Itaru-Kitano/CoolingBoxWireOrganizer/CoolingBoxWireOrganizer_bom.xlsx

Reference | Value | Datasheet | Qty | 購入ページ | 説明 | 型番 | 金額/個 | 金額 | メモ
C1 | 0.1u | https://www.mouser.jp/datasheet/2/40/KGF-3223650.pdf | 1 | https://www.mouser.jp/ProductDetail/KYOCERA-AVX/KGF15AR71E104KT?qs=Jm2GQyTW%2FbhgeBrrzHnuTw%3D%3D | capacitor | KGF15AR71E104KT | 23 | 23
C2,C3,C4,C5 | 0.01u | https://www.mouser.jp/datasheet/2/281/1/GCM188R71H103KA37_01C-3144181.pdf | 4 | https://www.mouser.jp/ProductDetail/Murata-Electronics/GCM188R71H103KA37J?qs=N3Kl9KD794T3%2FxlXdF0Axg%3D%3D | capacitor | GCM188R71H103KA37J | 26 | 104
D1,D2,D3,D4,D5,D6,D8 | D | https://www.mouser.jp/datasheet/2/80/CDBU0245_HF_RevB-2489203.pdf | 7 | https://www.mouser.jp/ProductDetail/Comchip-Technology/CDBU0245?qs=tw%252BuQ%2FB6PO2XscGM2Q%2FbYQ%3D%3D | diode | CDBU0245 | 55 | 385
J1,J11,J16 | Conn_02x02_Odd_Even | https://www.molex.com/en-us/products/part-detail/5013310407?display=pdf | 3 | https://www.mouser.jp/ProductDetail/Molex/501331-0407?qs=uEWtSLL707WjgxFGXkXwvQ%3D%3D | pico-clasp connector-4pin | 501331-0407 | 102 | 306
J2,J4 | Conn_01x02 | https://www.molex.com/en-us/products/part-detail/430450215?display=pdf | 2 | https://www.mouser.jp/ProductDetail/Molex/43045-0215?qs=R7%2FZKp6KZ2Zl1geLRuWqAQ%3D%3D | micro-fit connector-2pin | 43045-0215 | 363 | 726
J3 | Conn_01x08 | https://www.molex.com/en-us/products/part-detail/5013310807?display=pdf | 1 | https://www.mouser.jp/ProductDetail/Molex/501331-0807?qs=uEWtSLL707WCWoLr2aeFsQ%3D%3D | pico-clasp connector-8pin | 501331-0807 | 124 | 124
J5 | Conn_01x10_Pin | https://app.adam-tech.com/products/download/data_sheet/201605/ph1-xx-ua-data-sheet.pdf | 1 | https://www.digikey.jp/ja/products/detail/adam-tech/PH1-10-UA/9830653?productid=9830653&gad_source=1 | pin header_1x10_p2.54_vertical | PH1-10-UA | 29 | 29
J6,J7,J8,J10,J13 | Conn_01x08_Pin | https://app.adam-tech.com/products/download/data_sheet/201605/ph1-xx-ua-data-sheet.pdf | 5 | https://www.digikey.jp/ja/products/detail/adam-tech/PH1-08-UA/9830442?productid=9830442&gad_source=1 | pin header_1x08_p2.54_vertical | PH1-08-UA | 24 | 120
J9,J12 | Conn_02x03_Odd_Even | https://www.molex.com/en-us/products/part-detail/430450615?display=pdf | 2 | https://www.mouser.jp/ProductDetail/Molex/43045-0615?qs=ODlIKnK5hgef9VmmmFfM0A%3D%3D | micro-fit connector-6pin | 43045-0615 | 540 | 1080
J15 | Conn_02x18_Odd_Even | https://app.adam-tech.com/products/download/data_sheet/202065/ph2-xx-ua-data-sheet.pdf | 1 | https://www.digikey.jp/ja/products/detail/adam-tech/PH2-18-UA/9830421 | pin header_2x18_p2.54_vertical | PH2-18-UA | 49 | 49
J18,J19,J23 | DILB16P-223TLF | https://www.mouser.jp/datasheet/2/18/1/10052485-2577567.pdf | 3 | https://www.mouser.jp/ProductDetail/Amphenol-FCI/DILB16P-223TLF?qs=dNsYR%2FH0PyMYRp3sTWpoVA%3D%3D&gad_source=1 | dip socket for relay | DILB16P-223TLF | 71 | 213
L1,L2,L3,L4,L5,L6,L7,L8 | L_Ferrite | https://www.mouser.jp/datasheet/2/281/ENFA0003-1915778.pdf | 8 | https://www.mouser.jp/ProductDetail/Murata-Electronics/BLM18KG331SN1D?qs=rvfpa0%252BU10NzC2vi4JWfgQ%3D%3D | ferrite bead | BLM18KG331SN1D | 17 | 136
R1,R12,R13,R15,R17,R19 | 10000 | https://www.vishay.com/docs/20035/dcrcwe3.pdf | 6 | https://www.mouser.jp/ProductDetail/Vishay-Dale/CRCW060310K0FKEI | resistor 10k ohm | CRCW060310K0FKEI | 17 | 102
R2 | 3900 | https://www.vishay.com/docs/28758/tnpw_e3.pdf | 1 | https://www.mouser.jp/ProductDetail/Vishay-Dale/TNPW06033K90BEEA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 | resistor 3.9k ohm | TNPW06033K90BEEA | 63 | 63
R3 | 1800 | https://www.mouser.jp/datasheet/2/315/AOA0000C307-1149632.pdf | 1 | https://www.mouser.jp/ProductDetail/Panasonic/ERA-3ARB182V | resistor 1.8k ohm | ERA-3ARB182V | 91 | 91
R4,R5,R6,R7,R8,R9,R10,R11 | 390 | https://www.vishay.com/docs/28952/mcs0402at-mct0603at-mcu0805at-mca1206at.pdf | 8 | https://www.mouser.jp/ProductDetail/Vishay/MCT0603MD3900BP500 | resistor 390k ohm | MCT0603MD3900BP500 | 71 | 568
R14,R16,R18,R20 | 1000 | https://www.vishay.com/docs/28705/mcx0x0xpro.pdf | 4 | https://www.mouser.jp/ProductDetail/Vishay-Beyschlag/MCT06030C1001FP500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 | resistor 1k ohm | MCT06030C1001FP500 | 17 | 68
U1,U2,U3,U4 | MAX31855KASA | http://datasheets.maximintegrated.com/en/ds/MAX31855.pdf | 4 | https://www.mouser.jp/ProductDetail/Analog-Devices-Maxim-Integrated/MAX31855KASA+T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 | max31855 | MAX31855KASA+T | 1450 | 5800
J14,J17,J21,J22 | Conn_01x02 | https://www.molex.com/en-us/products/part-detail/5013310207?display=pdf | 4 | https://www.mouser.jp/ProductDetail/Molex/501331-0207?qs=uEWtSLL707XUoNps1caEaA%3D%3D | pico-clasp connector-2pin | 501331-0207 | 92 | 368
J20 | Conn_02x03_Odd_Even | https://app.adam-tech.com/products/download/data_sheet/202065/ph2-xx-ua-data-sheet.pdf | 1 | https://www.digikey.jp/ja/products/detail/adam-tech/PH2-06-UA/9830396?productid=9830396&gad_source=1 | pin header_2x03_p2.54_vertical | PH2-06-UA | 18 | 18
 |  |  |  |  |  |  |  | 0
 |  |  |  |  |  |  |  | 0
 |  | https://www.molex.com/content/dam/molex/molex-dot-com/products/automated/en-us/salesdrawingpdf/501/501330/5013300400_sd.pdf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 | 3 | https://www.mouser.jp/ProductDetail/Molex/501330-0400?qs=aXGKoampmnm6Ru8v6Lp%2Frg%3D%3D | pico-clasp housing-4pin | 501330-0400 | 38 | 114
 |  | https://www.molex.com/en-us/products/part-detail/430250200?display=pdf | 2 | https://www.mouser.jp/ProductDetail/Molex/43025-0200?qs=4XSMV6Twtb2B3B7qTwcqgQ%3D%3D | micro-fit housing-2pin | 43025-0200 | 55 | 110
 |  | https://www.molex.com/en-us/products/part-detail/5013300800?display=pdf | 1 | https://www.mouser.jp/ProductDetail/Molex/501330-0800?qs=aXGKoampmnmr%252BxiReHihlw%3D%3D | pico-clasp housing-8pin | 501330-0800 | 35 | 35
 |  | https://www.molex.com/en-us/products/part-detail/430250600?display=pdf | 2 | https://www.mouser.jp/ProductDetail/Molex/43025-0600?qs=mrPiglD9aYJrq7XWj%2FGMFg%3D%3D | micro-fit housing-6pin | 43025-0600 | 86 | 172
 |  | https://www.molex.com/en-us/products/part-detail/5013300200?display=pdf | 4 | https://www.mouser.jp/ProductDetail/Molex/501330-0200?qs=uEWtSLL707VDdEXASWutQw%3D%3D | pico-clasp housing-2pin | 501330-0200 | 53 | 212
 |  | https://www.molex.com/en-us/products/part-detail/5011937000?display=pdf | 28 | https://www.mouser.jp/ProductDetail/Molex/501193-7000?qs=d0WKAl%252BL4KbeebyzLG7lVA%3D%3D | pico-clasp crimp | 501193-7000 | 28 | 784
 |  | https://www.molex.com/content/dam/molex/molex-dot-com/products/automated/en-us/salesdrawingpdf/430/43030/430300001_sd.pdf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 | 16 | https://www.mouser.jp/ProductDetail/Molex/43030-0002-Cut-Strip | micro-fit crimp | 43030-0002 | 17 | 272
 |  |  |  |  |  |  |  | 0
 |  | https://omronfs.omron.com/en_US/ecb/products/pdf/en-g3vm_41ar_dr.pdf | 12 | https://www.digikey.jp/ja/products/detail/omron-electronics-inc-emc-div/G3VM-41AR/3175479 | control relay | G3VM-41AR | 1323 | 15876
 |  | https://www.mouser.jp/datasheet/2/307/OMRNS02519_1-2559982.pdf | 2 | https://www.mouser.jp/ProductDetail/Omron-Automation-and-Safety/G2R-1-SN-DC12S?qs=CQJ0XtrV64ulWIzWmO6GHQ%3D%3D | peltier power relay | G2R-1-SN-DC12 | 2353 | 4706
 |  |  | 3 | https://www.monotaro.com/p/5059/4050/?t.q=p2rfz-05-e | peltier power relay DIN rail socket | P2RFZ-05-E | 479 | 1437
 |  | https://mm.digikey.com/Volume0/opasdata/d220001/medias/docus/2878/HE%20Relays%20TV-10%2C15.pdf | 1 | https://www.digikey.jp/ja/products/detail/panasonic-electric-works/HE1AN-S-DC12V/570790 | AC100V inter lock power relay | HE1AN-S-DC12V | 2581 | 2581
 |  | https://industry.panasonic.com/global/en/downloads/?file_cd=401131&tab=catalog&series_cd=2463 | 1 | https://www.digikey.jp/ja/products/detail/panasonic-electric-works/JH1-SF/635214 | AC100V inter lock power relay DIN rail socket | JH1-SF | 1838 | 1838
 |  |  |  |  |  |  |  | 0
 |  |  |  |  |  |  |  | 0
 |  |  |  |  |  |  |  | 0
 |  |  | 1 | https://www.amazon.co.jp/%E3%82%A8%E3%83%B3%E3%82%B8%E3%83%8B%E3%82%A2-%E7%B2%BE%E5%AF%86%E5%9C%A7%E7%9D%80%E3%83%9A%E3%83%B3%E3%83%81-%E3%83%80%E3%82%A4%E3%8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 | crimping tool | PAD-11 | 7445 | 7445
 |  | https://www.mouser.jp/datasheet/2/260/MWEC_S_A0013016761_1-2552161.pdf | 1 | https://www.mouser.jp/ProductDetail/MEAN-WELL/MDR-60-12 | power supply 12V | MDR-60-12 | 3841 | 3841
 |  |  |  |  |  |  |  | 0
 |  |  |  |  |  |  |  | 0
 |  |  |  |  |  |  |  | 0
 |  | https://www.phoenixcontact.com/en-us/products/distributor-terminal-block-ptfix-66x25-ns35a-gy-3273198?type=pdf | 3 | https://www.digikey.jp/ja/products/detail/phoenix-contact/3273198/7596982 | terminal block | 3273198 | 656 | 1968 | 九州大学
 |  | https://mm.digikey.com/Volume0/opasdata/d220001/medias/docus/388/3210499.pdf | 2 | https://www.digikey.jp/ja/products/detail/phoenix-contact/3210499/2263754 | power cord splicing | 3210499 | 1219 | 2438 | 九州大学
 |  |  |  |  |  |  |  |  | 九州大学
 |  |  |  |  |  |  |  | 0 | 九州大学
 |  |  | 2 | https://www.yukilabo.co.jp/index.php?LECOFRAME | Circuit Base Pillar | F25L-415.0-2-U | 740/m | 1994 | 九州大学
 |  |  | 4 |  | 鉄後入れTロック25 | TL2X | 110 | 440 | 九州大学
 |  |  | 4 |  | テーパーボルト25 | TB25 | 30 | 120 | 九州大学
 |  |  | 12 |  | Fナット25 | NF25-M4 | 32 | 384 | 九州大学
 |  |  |  |  |  |  |  | 0 | 九州大学
 |  |  | 1 | https://www.monotaro.com/p/0964/9981/?t.q=9649981 | アルミ(A5052)切板 厚さ3mm(Front Panel) |  | 3290 | 3290 | 九州大学
 |  |  | 2 | https://www.monotaro.com/p/3710/8881/?t.q=37108881 | 配線ダクト |  | 1898 | 3796 | 九州大学
 |  |  | 2 | https://www.monotaro.com/p/6729/8762/?t.q=67298762 | DINレール |  | 399 | 798 | 九州大学
 |  |  |  |  |  |  | 合計金額 | 65024
