Itaru-Kitano/CoolingBoxWireOrganizer/(commit log)

2024-06-17 change Vin of MAX31855 5V to 3.3V
    [CoolingBoxWireOrganizer.kicad_pcb, CoolingBoxWireOrganizer.kicad_sch]
2024-06-19 fix the edge of 5V and 3.3V
    [CoolingBoxWireOrganizer.kicad_pcb]
2024-06-19 add power connector in sch
    [CoolingBoxWireOrganizer.kicad_pcb, CoolingBoxWireOrganizer.kicad_sch]
2024-06-19 add two 2x2 digital connector and analog spare connector. Then, some wire connected.
    [CoolingBoxWireOrganizer.kicad_pcb, CoolingBoxWireOrganizer.kicad_sch]
2024-06-20 connected all wires, added text, and conducted DRC
    [CoolingBoxWireOrganizer.kicad_pcb, CoolingBoxWireOrganizer.kicad_sch]
2024-06-20 fix some details
    [CoolingBoxWireOrganizer-B_Cu.gbr, CoolingBoxWireOrganizer-B_Mask.gbr, CoolingBoxWireOrganizer-B_Paste.gbr, CoolingBoxWireOrganizer-B_Silkscreen.gbr, CoolingBoxWireOrganizer-Edge_Cuts.gbr, CoolingBoxWireOrganizer-F_Cu.gbr, CoolingBoxWireOrganizer-F_Mask.gbr, CoolingBoxWireOrganizer-F_Paste.gbr]
2024-06-28 take enoough space to nut be turned. chage the configuration of spare connector
    [CoolingBoxWireOrganizer.kicad_pcb, CoolingBoxWireOrganizer.kicad_sch]
2024-07-02 complete version 1.1
    [CoolingBoxWireOrganizer.kicad_pcb]
2024-07-02 add circuit around chiller alarm and chiller read signal
    [CoolingBoxWireOrganizer.kicad_pcb, CoolingBoxWireOrganizer.kicad_sch]
2024-07-04 add circuit around chiller alarm
    [CoolingBoxWireOrganizer.kicad_pcb, CoolingBoxWireOrganizer.kicad_sch]
2024-07-09 change one digital spare to reset.
    [CoolingBoxWireOrganizer.kicad_pcb, CoolingBoxWireOrganizer.kicad_sch]
2024-07-11 add SSR circuit
    [CoolingBoxWireOrganizer.kicad_pcb, CoolingBoxWireOrganizer.kicad_sch]
2024-07-12 fix details.
    [CoolingBoxWireOrganizer.kicad_pcb]
2024-08-27 add MAX31855
    [CoolingBoxWireOrganizer.kicad_pcb, CoolingBoxWireOrganizer.kicad_sch]
2024-08-27 add relay(G3VM-41AR) except AC100V_intlk(chiller)'s relay. And delete MAX31855's molex connector that is remains of version1.2
    [CoolingBoxWireOrganizer.kicad_pcb, CoolingBoxWireOrganizer.kicad_sch]
2024-08-27 set the connector to each devices at the latter part of the relay(G3VM-41AR).
    [CoolingBoxWireOrganizer.kicad_pcb, CoolingBoxWireOrganizer.kicad_sch]
2024-08-29 before change branch
    [CoolingBoxWireOrganizer.kicad_pcb, CoolingBoxWireOrganizer.kicad_sch]
2024-08-30 add capacitor to MAX31855, and connect the thermocouple terminal to MAX31855.
    [CoolingBoxWireOrganizer.kicad_pcb, CoolingBoxWireOrganizer.kicad_sch]
2024-08-30 before changing branch
    [CoolingBoxWireOrganizer.kicad_pcb, CoolingBoxWireOrganizer.kicad_sch]
2024-09-05 update circuit around MAX31855 (imitate MAX board module).
    [CoolingBoxWireOrganizer.kicad_pcb, CoolingBoxWireOrganizer.kicad_sch]
2024-09-07 started to design wiring but there isn't enough space. So, I will try to change molex connector mini-fit to micro-fit which is SMD in another branch(version2.1).
    [CoolingBoxWireOrganizer.kicad_pcb, CoolingBoxWireOrganizer.kicad_sch]
2024-09-11 added almost all parts and decided the location of them and designed some wires. I need to add emergency cuicuit and chiller alarm circuit futher more later.
    [CoolingBoxWireOrganizer.kicad_pcb, CoolingBoxWireOrganizer.kicad_sch]
2024-09-16 add diodes for back electromotive force absorption to chiller alarm circuit
    [CoolingBoxWireOrganizer.kicad_pcb, CoolingBoxWireOrganizer.kicad_sch]
2024-09-17 fix details
    [CoolingBoxWireOrganizer.kicad_pcb, CoolingBoxWireOrganizer_bom.csv, CoolingBoxWireOrganizer_bom.xlsx]
2024-10-03 fix the wires around MAX31855
    [CoolingBoxWireOrganizer.kicad_pcb, CoolingBoxWireOrganizer.kicad_sch, CoolingBoxWireOrganizer_bom.xlsx]
2024-10-03 edited bom
    [CoolingBoxWireOrganizer_bom.xlsx]
2024-10-04 add peltier power relay socket to bom
    [CoolingBoxWireOrganizer_bom.xlsx]
2024-10-06 fix the bom
    [CoolingBoxWireOrganizer_bom.xlsx]
2024-10-07 add gerber file
    [CoolingBoxWireOrganizer-B_Cu.gbr, CoolingBoxWireOrganizer-B_Mask.gbr, CoolingBoxWireOrganizer-B_Paste.gbr, CoolingBoxWireOrganizer-B_Silkscreen.gbr, CoolingBoxWireOrganizer-Edge_Cuts.gbr, CoolingBoxWireOrganizer-F_Cu.gbr, CoolingBoxWireOrganizer-F_Mask.gbr, CoolingBoxWireOrganizer-F_Paste.gbr]
2024-10-07 add information of terminal block and what is used at Kyushu site
    [CoolingBoxWireOrganizer.kicad_pcb, CoolingBoxWireOrganizer_bom.xlsx]
2024-10-08 change the Vin to GND about Arduino control
    [CoolingBoxWireOrganizer.kicad_pcb, CoolingBoxWireOrganizer.kicad_sch]
2024-10-08 update gerber file
    [CoolingBoxWireOrganizer-B_Cu.gbr, CoolingBoxWireOrganizer-B_Mask.gbr, CoolingBoxWireOrganizer-B_Paste.gbr, CoolingBoxWireOrganizer-B_Silkscreen.gbr, CoolingBoxWireOrganizer-Edge_Cuts.gbr, CoolingBoxWireOrganizer-F_Cu.gbr, CoolingBoxWireOrganizer-F_Mask.gbr, CoolingBoxWireOrganizer-F_Paste.gbr]
2024-10-08 change the silk 'Arduino control' to 'Arduino reset'
    [CoolingBoxWireOrganizer-B_Cu.gbr, CoolingBoxWireOrganizer-B_Mask.gbr, CoolingBoxWireOrganizer-B_Paste.gbr, CoolingBoxWireOrganizer-B_Silkscreen.gbr, CoolingBoxWireOrganizer-Edge_Cuts.gbr, CoolingBoxWireOrganizer-F_Cu.gbr, CoolingBoxWireOrganizer-F_Mask.gbr, CoolingBoxWireOrganizer-F_Paste.gbr]
2024-10-08 update the gerber file
2024-10-23 change the format of bom(add memo)
    [CoolingBoxWireOrganizer_bom.xlsx]
2024-10-23 organaize version2.1 folder
    [CoolingBoxWireOrganizer_bom.csv]
2024-10-23 2 organaize version2.1 folder
    [CoolingBoxWireOrganizer-B_Cu.gbr, CoolingBoxWireOrganizer-B_Mask.gbr, CoolingBoxWireOrganizer-B_Paste.gbr, CoolingBoxWireOrganizer-B_Silkscreen.gbr, CoolingBoxWireOrganizer-Edge_Cuts.gbr, CoolingBoxWireOrganizer-F_Cu.gbr, CoolingBoxWireOrganizer-F_Mask.gbr, CoolingBoxWireOrganizer-F_Paste.gbr]
